Maltheren/Connectivity_3band_LoRaboard/3band_testboard_mcu_based.jpg

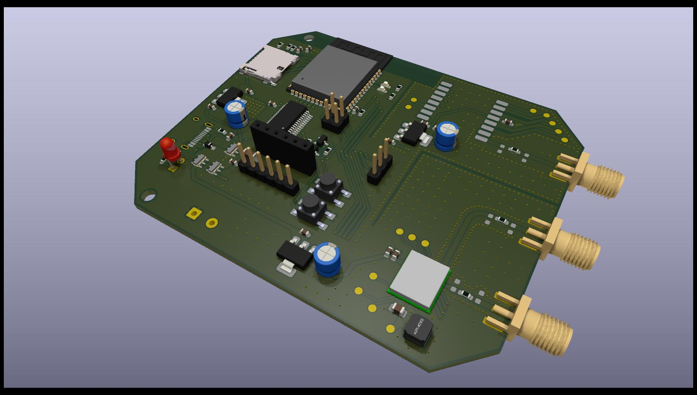
3band_testboard_mcu_based.jpg
