Maltheren/Connectivity_3band_LoRaboard/README.md

# Connectivity_3band_LoRaboard
The first revision lora testboards for the tunnel measurement project
