Maltheren/Connectivity_3band_LoRaboard/Price.ods

Sheet: Sheet1
Component | qty pr board | Price unit | Price tot. | Link
LBAA0XV2GT-001 | 1 | 94.5 | 94.5 | https://eu.mouser.com/ProductDetail/Murata-Electronics/LBAA0XV2GT-001?qs=2wMNvWM5ZX62gobY4BYcIQ%3D%3D
RFM96W-433S2 | 1 | 54.82 | 54.82 | https://www.tme.eu/it/en/details/rfm96w-433s2/rf-modules/hope-microelectronics/
LM1117MPX-3.3 | 3 | 7.03 | 21.09 | https://eu.mouser.com/ProductDetail/Texas-Instruments/LM1117MPX-3.3-NOPB?qs=X1J7HmVL2ZHRbBIxXi4utg%3D%3D
ESP32-S3-WROOM-1-N8R8 | 1 | 25.7 | 25.7 | https://www.mouser.dk/ProductDetail/Espressif-Systems/ESP32-S3-WROOM-1-N8R8?qs=7D1LtPJG0i3%2F28hKFavOpQ%3D%3D
USB-C | 1 | 6.13 | 6.13 | https://dk.farnell.com/gct-global-connector-technology/usb4105-gf-a/usb-conn-2-0-type-c-rcpt-16pos/dp/3588205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
SMA-connectors | 3 | 17.03 | 51.09 | https://www.mouser.dk/ProductDetail/RF-Solutions/CON-SMA-EDGE?qs=UkDUCjYnTB3wOPRCaplkvw%3D%3D&gQT=2
USB-UART | 1 | 34.06 | 34.06 | https://www.mouser.dk/ProductDetail/FTDI/FT232RNL-REEL?qs=By6Nw2ByBD3LSfXryh9qRQ%3D%3D
SD-card socket | 1 | 11.58 | 11.58 | https://www.mouser.dk/ProductDetail/Amphenol-Commercial-Products/1140084168?qs=tcdQdce0DUrgPsHyuD5Law%3D%3D
Switches | 2 | 1.21 | 2.42 | https://www.mouser.co.uk/ProductDetail/E-Switch/TL3305BF100QG?qs=IKkN%2F947nfDIPwqPQja%252BvQ%3D%3D
Inductors | 1 | 1.78 | 1.78 | https://www.mouser.dk/ProductDetail/ABRACON/ASPI-4030S-100M-T?qs=BLmuIjeT3qH3cD5M%252B06ufg%3D%3D
Komponenter pr board: |  |  | 303.17 | dkk
PCB prisoverslag | qty | pris pr pcb | pris total
5 PCB’er med ENIG | 5 | 25.548 | 127.74 | https://cart.jlcpcb.com/quote?orderType=1&stencilLayer=2&stencilWidth=100&stencilLength=100&stencilCounts=5
10 PCB’er med ENIG | 10 | 15.508 | 155.08
Endelig pris pr board: | qty | stk | tot ca. Dkk | Her kommer der lige fragt oveni
 | 5 | 328.718 | 1643.59
 | 10 | 318.678 | 3186.78
Alternativ hvor køber 5 PCB’er. Men kun monterer et par stykker | 2 | 367.04 | 734.08
 | 3 | 345.75 | 1037.25
 | 4 | 335.105 | 1340.42
 | 5 | 328.718 | 1643.59

Sheet: Ark1
Indkøbsliste:
Component | Antal | Pris enhed | Pris tot | Note | Link mouser:
LBAA0XV2GT-001 | 3 | 94.5 | 283.5 | 1 Ekstra | https://eu.mouser.com/ProductDetail/Murata-Electronics/LBAA0XV2GT-001?qs=2wMNvWM5ZX62gobY4BYcIQ%3D%3D
RFM96W-433S2 | 3 | 54.82 | 164.46 | 1 Ekstra | https://www.tme.eu/it/en/details/rfm96w-433s2/rf-modules/hope-microelectronics/
LM1117MPX-3.3 | 10 | 5.06 | 50.6 | 10 koster 8 kr mere, og de kan bruges fremover | https://eu.mouser.com/ProductDetail/Texas-Instruments/LM1117MPX-3.3-NOPB?qs=X1J7HmVL2ZHRbBIxXi4utg%3D%3D
ESP32-S3-WROOM-1-N8R8 | 3 | 25.7 | 77.1 | 1 Ekstra | https://www.mouser.dk/ProductDetail/Espressif-Systems/ESP32-S3-WROOM-1-N8R8?qs=7D1LtPJG0i3%2F28hKFavOpQ%3D%3D
USB-C | 3 | 6.13 | 18.39 | 1 Ekstra | https://dk.farnell.com/gct-global-connector-technology/usb4105-gf-a/usb-conn-2-0-type-c-rcpt-16pos/dp/3588205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
SMA-connectors | 10 | 14.79 | 147.9 | Ekstra vi kommer sandsynligvis til at skulle bruge flere af dem her i frem tiden | https://www.mouser.dk/ProductDetail/RF-Solutions/CON-SMA-EDGE?qs=UkDUCjYnTB3wOPRCaplkvw%3D%3D&gQT=2
USB-UART | 2 | 34.06 | 68.12 |  | https://www.mouser.dk/ProductDetail/FTDI/FT232RNL-REEL?qs=By6Nw2ByBD3LSfXryh9qRQ%3D%3D
SD-card socket | 3 | 11.58 | 34.74 | 1 Ekstra | https://www.mouser.dk/ProductDetail/Amphenol-Commercial-Products/1140084168?qs=tcdQdce0DUrgPsHyuD5Law%3D%3D
Switches | 4 | 1.21 | 4.84 |  | https://www.mouser.dk/ProductDetail/E-Switch/TL3305BF100QG?qs=IKkN%2F947nfDIPwqPQja%252BvQ%3D%3D
Inductors | 3 | 1.78 | 5.34 | 1 Ekstra | https://www.mouser.dk/ProductDetail/ABRACON/ASPI-4030S-100M-T?qs=BLmuIjeT3qH3cD5M%252B06ufg%3D%3D
 |  |  | Total for komonenter:
 |  |  | 854.99 | dkk
PCB | For 5 PCB'er | Fragt | link
Hos JLC. Den billigeste blyfri | 22,34 | 135,46 | https://cart.jlcpcb.com/quote?orderType=1&stencilLayer=2&stencilWidth=100&stencilLength=100
Hos JLC. Med ENIG
