Maltheren/Connectivity_3band_LoRaboard/3band_testboard_mcu_based/Inductor/ASPI-4030S-100M-T.stp

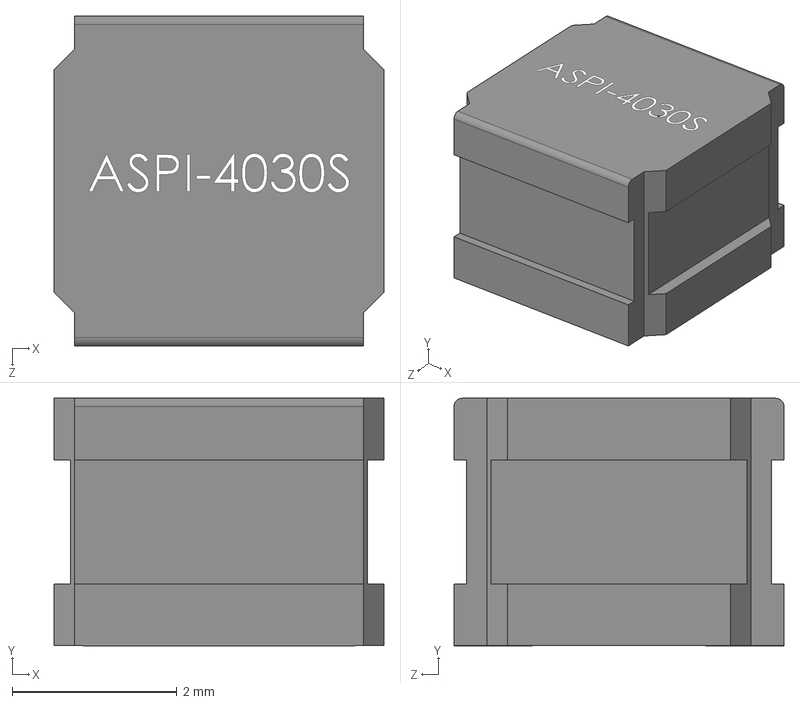
[picture p2: CAD file, 2025-04-08]
3band_testboard_mcu_based/Inductor/ASPI-4030S-100M-T.stp
4.00 x 3.00 x 4.00 mm
