Maltheren/Connectivity_3band_LoRaboard/3band_testboard_mcu_based/LBAA0XV2GT-001/LBAA0XV2GT-001.stp

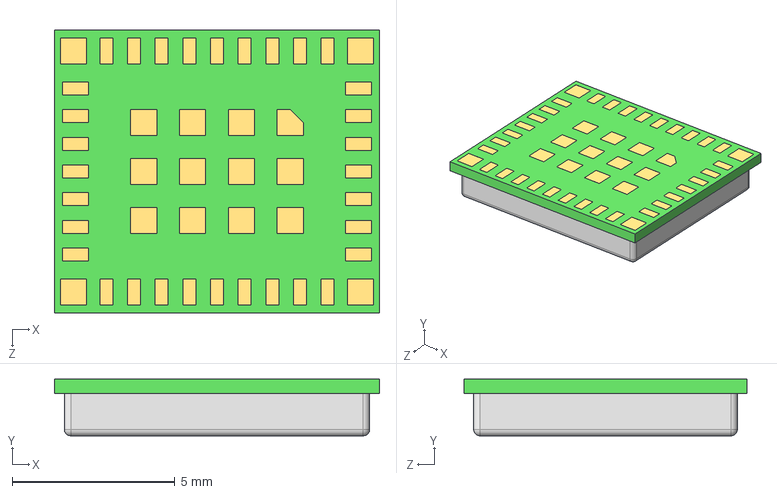
[picture p3: CAD file, 2025-03-31]
3band_testboard_mcu_based/LBAA0XV2GT-001/LBAA0XV2GT-001.stp
9.98 x 1.74 x 8.70 mm
