Maltheren/Connectivity_3band_LoRaboard/3band_testboard_mcu_based/Tactile_switch/TL3305BF100QG.stp

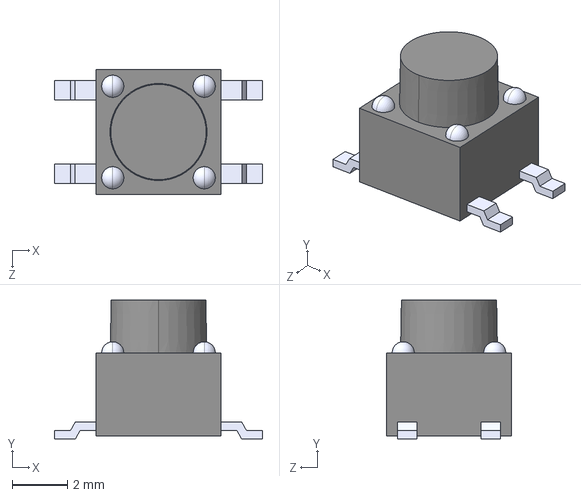
[picture p4: CAD file, 2025-04-08]
3band_testboard_mcu_based/Tactile_switch/TL3305BF100QG.stp
7.50 x 5.00 x 4.50 mm
