Maltheren/Connectivity_3band_LoRaboard/3band_testboard_mcu_based/SD_Card_holder/1140084168.stp

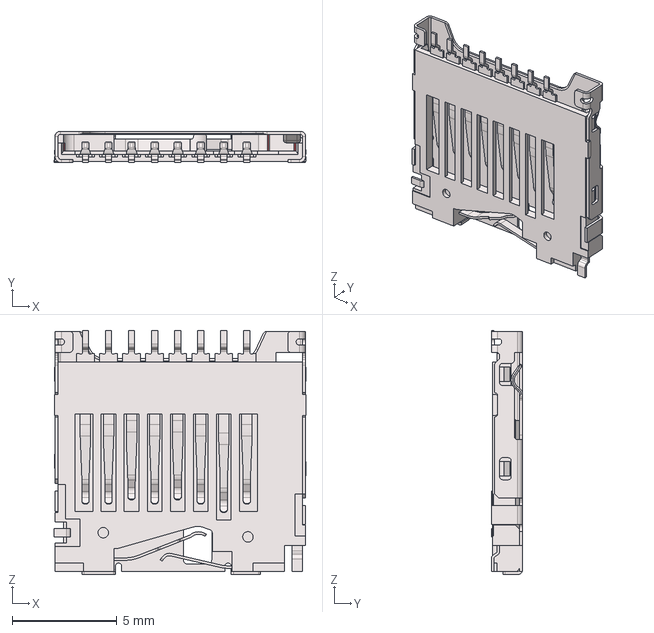
[picture p5: CAD file, 2025-03-31]
3band_testboard_mcu_based/SD_Card_holder/1140084168.stp
12.0 x 1.50 x 11.7 mm
