Maltheren/Connectivity_3band_LoRaboard/Final_Tunnel_SW_HW/Laptop_interface_and_measurements/readme.md

# Measurements and interface for python

### Eval.py
Den henter nogle af de graver frem der kunne bruges

### IOnode.py
Var den orignale kode der blev kørt for at hente værdierne sammen med rullebordet i tunnellen

### Rulletest1 mappen
Målinger udført med  
BW=500kHz, SF=6, CR=7
