Maltheren/Connectivity_3band_LoRaboard/3band_testboard_mcu_based/3band_testboard_mcu_based.kicad_pcb

## KiCad design 3band_testboard_mcu_based/3band_testboard_mcu_based.kicad_pcb (2025-05-11)

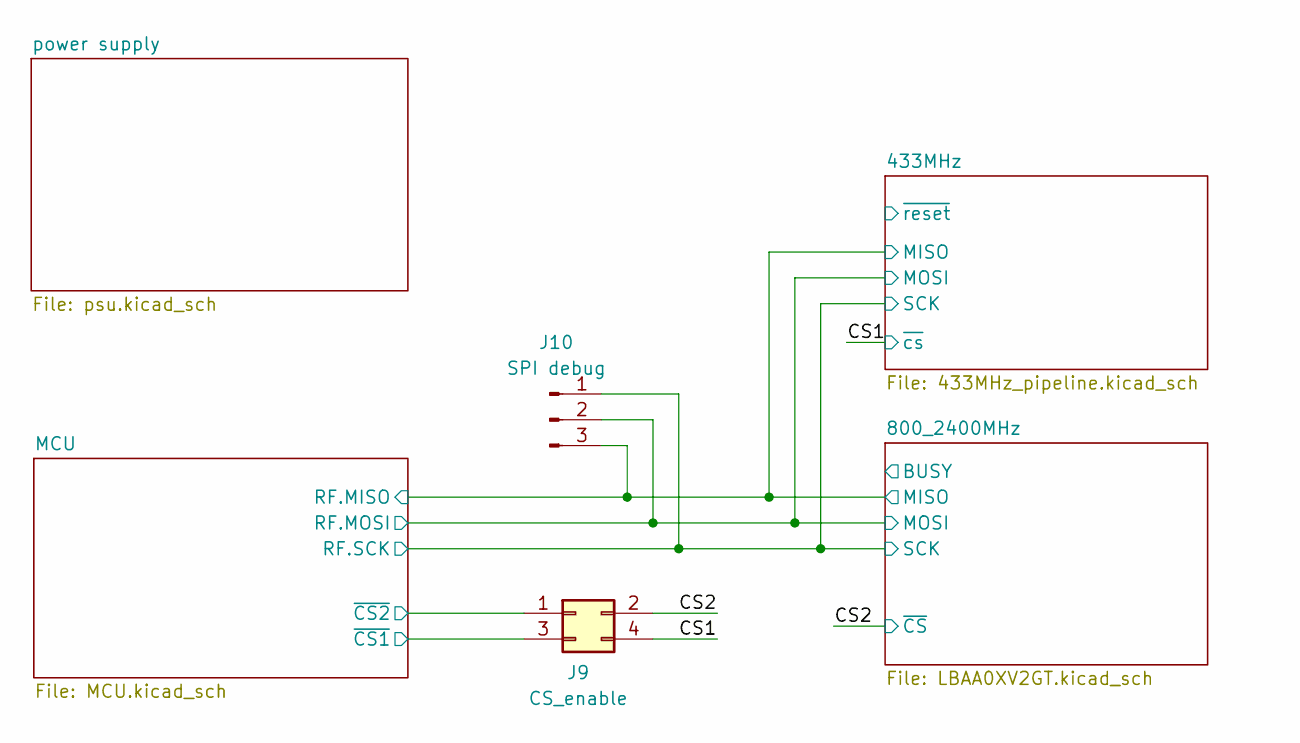
[picture p6: schematic 3band_testboard_mcu_based.kicad_sch, 3-band-LoRa testboard]

Parts:
J9: CS_enable; PinHeader_2x02_P2.54mm_Vertical
J10: SPI debug; PinHeader_1x03_P2.54mm_Vertical

Connections:
/433MHz/MISO: J10.3; also elsewhere on the board
/433MHz/MOSI: J10.2; also elsewhere on the board
/433MHz/SCK: J10.1; also elsewhere on the board
/CS1: J9.4; also elsewhere on the board
/CS2: J9.2; also elsewhere on the board
/MCU/~CS1: J9.3; also elsewhere on the board
/MCU/~CS2: J9.1; also elsewhere on the board

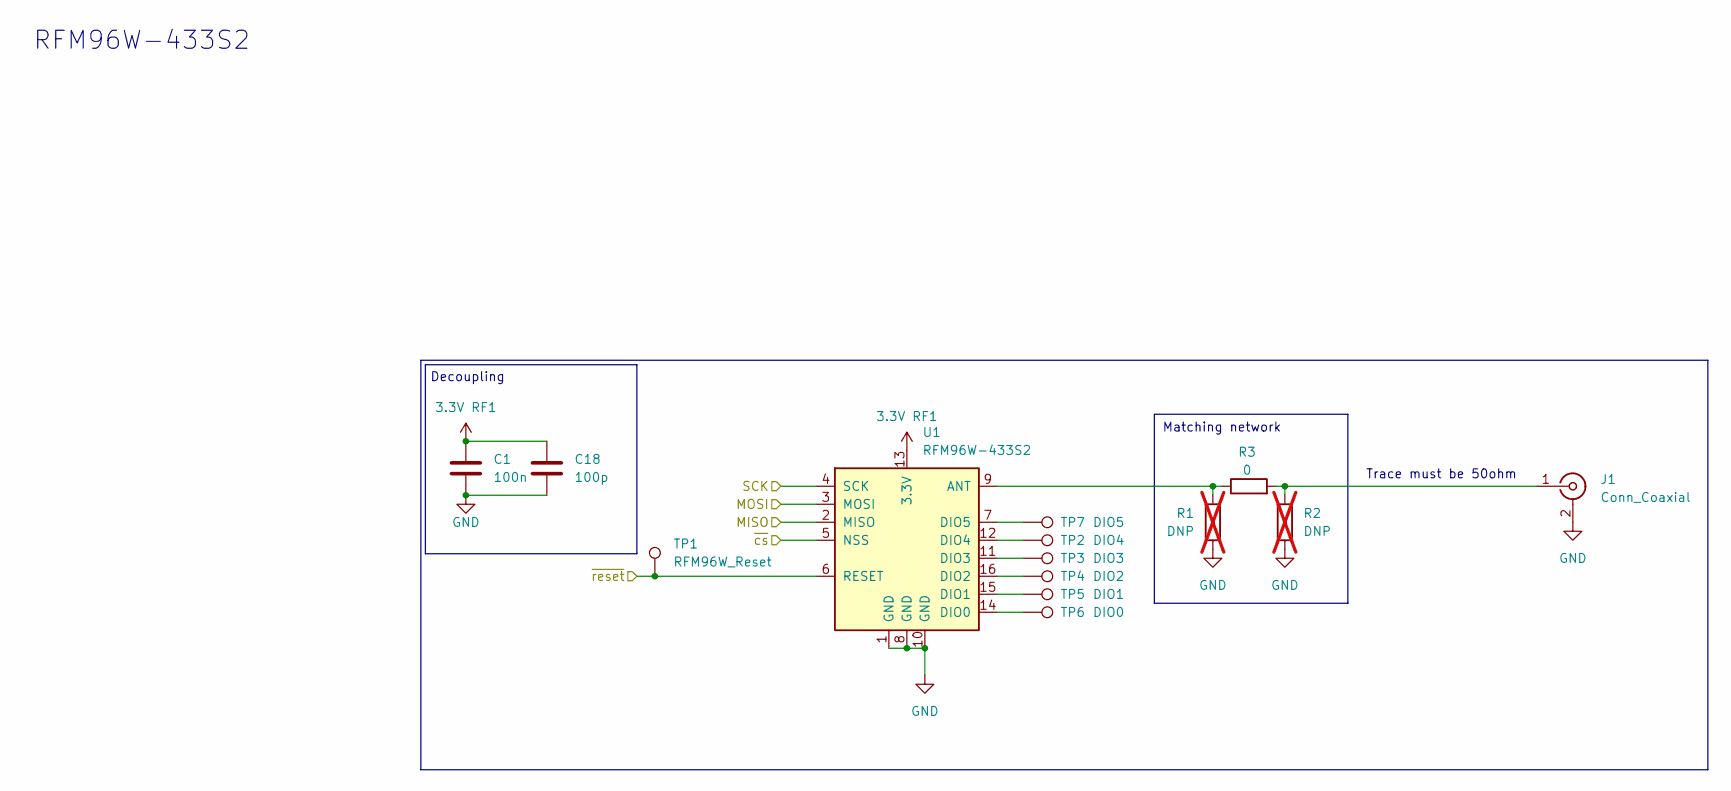
[picture p7: schematic 433MHz_pipeline.kicad_sch, 3-band-LoRa testboard]

Parts:
C1: 100n; C_0603_1608Metric_Pad1.08x0.95mm_HandSolder
C18: 100p; C_0603_1608Metric_Pad1.08x0.95mm_HandSolder
J1: Conn_Coaxial; SMA_Samtec_SMA-J-P-H-ST-EM1_EdgeMount
R1, R2: DNP; R_0603_1608Metric_Pad0.98x0.95mm_HandSolder; not fitted
R3: 0; R_0603_1608Metric_Pad0.98x0.95mm_HandSolder
TP1: RFM96W_Reset; TestPoint_Pad_D1.5mm
TP2: DIO4; TestPoint_Pad_D1.5mm
TP3: DIO3; TestPoint_Pad_D1.5mm
TP4: DIO2; TestPoint_Pad_D1.5mm
TP5: DIO1; TestPoint_Pad_D1.5mm
TP6: DIO0; TestPoint_Pad_D1.5mm
TP7: DIO5; TestPoint_Pad_D1.5mm
U1: RFM96W-433S2; HOPERF_RFM9XW_SMD

Connections:
3.3V RF1: C1.1, C18.1, U1.13 (3.3V); also elsewhere on the board
/433MHz/MISO: U1.2 (MISO); also elsewhere on the board
/433MHz/MOSI: U1.3 (MOSI); also elsewhere on the board
/433MHz/SCK: U1.4 (SCK); also elsewhere on the board
/433MHz/~reset: TP1.1, U1.6 (RESET)
/CS1: U1.5 (NSS); also elsewhere on the board
GND: C1.2, C18.2, J1.2 (Ext), R1.2, R2.2, U1.1 (GND), U1.8 (GND), U1.10 (GND); also elsewhere on the board
unnamed: J1.1 (In), R2.1, R3.2
unnamed: R1.1, R3.1, U1.9 (ANT)
unnamed: TP6.1, U1.14 (DIO0)
unnamed: TP5.1, U1.15 (DIO1)
unnamed: TP4.1, U1.16 (DIO2)
unnamed: TP3.1, U1.11 (DIO3)
unnamed: TP2.1, U1.12 (DIO4)
unnamed: TP7.1, U1.7 (DIO5)

Notes on the sheet:
RFM96W-433S2
Matching network
Trace must be 50ohm
Decoupling

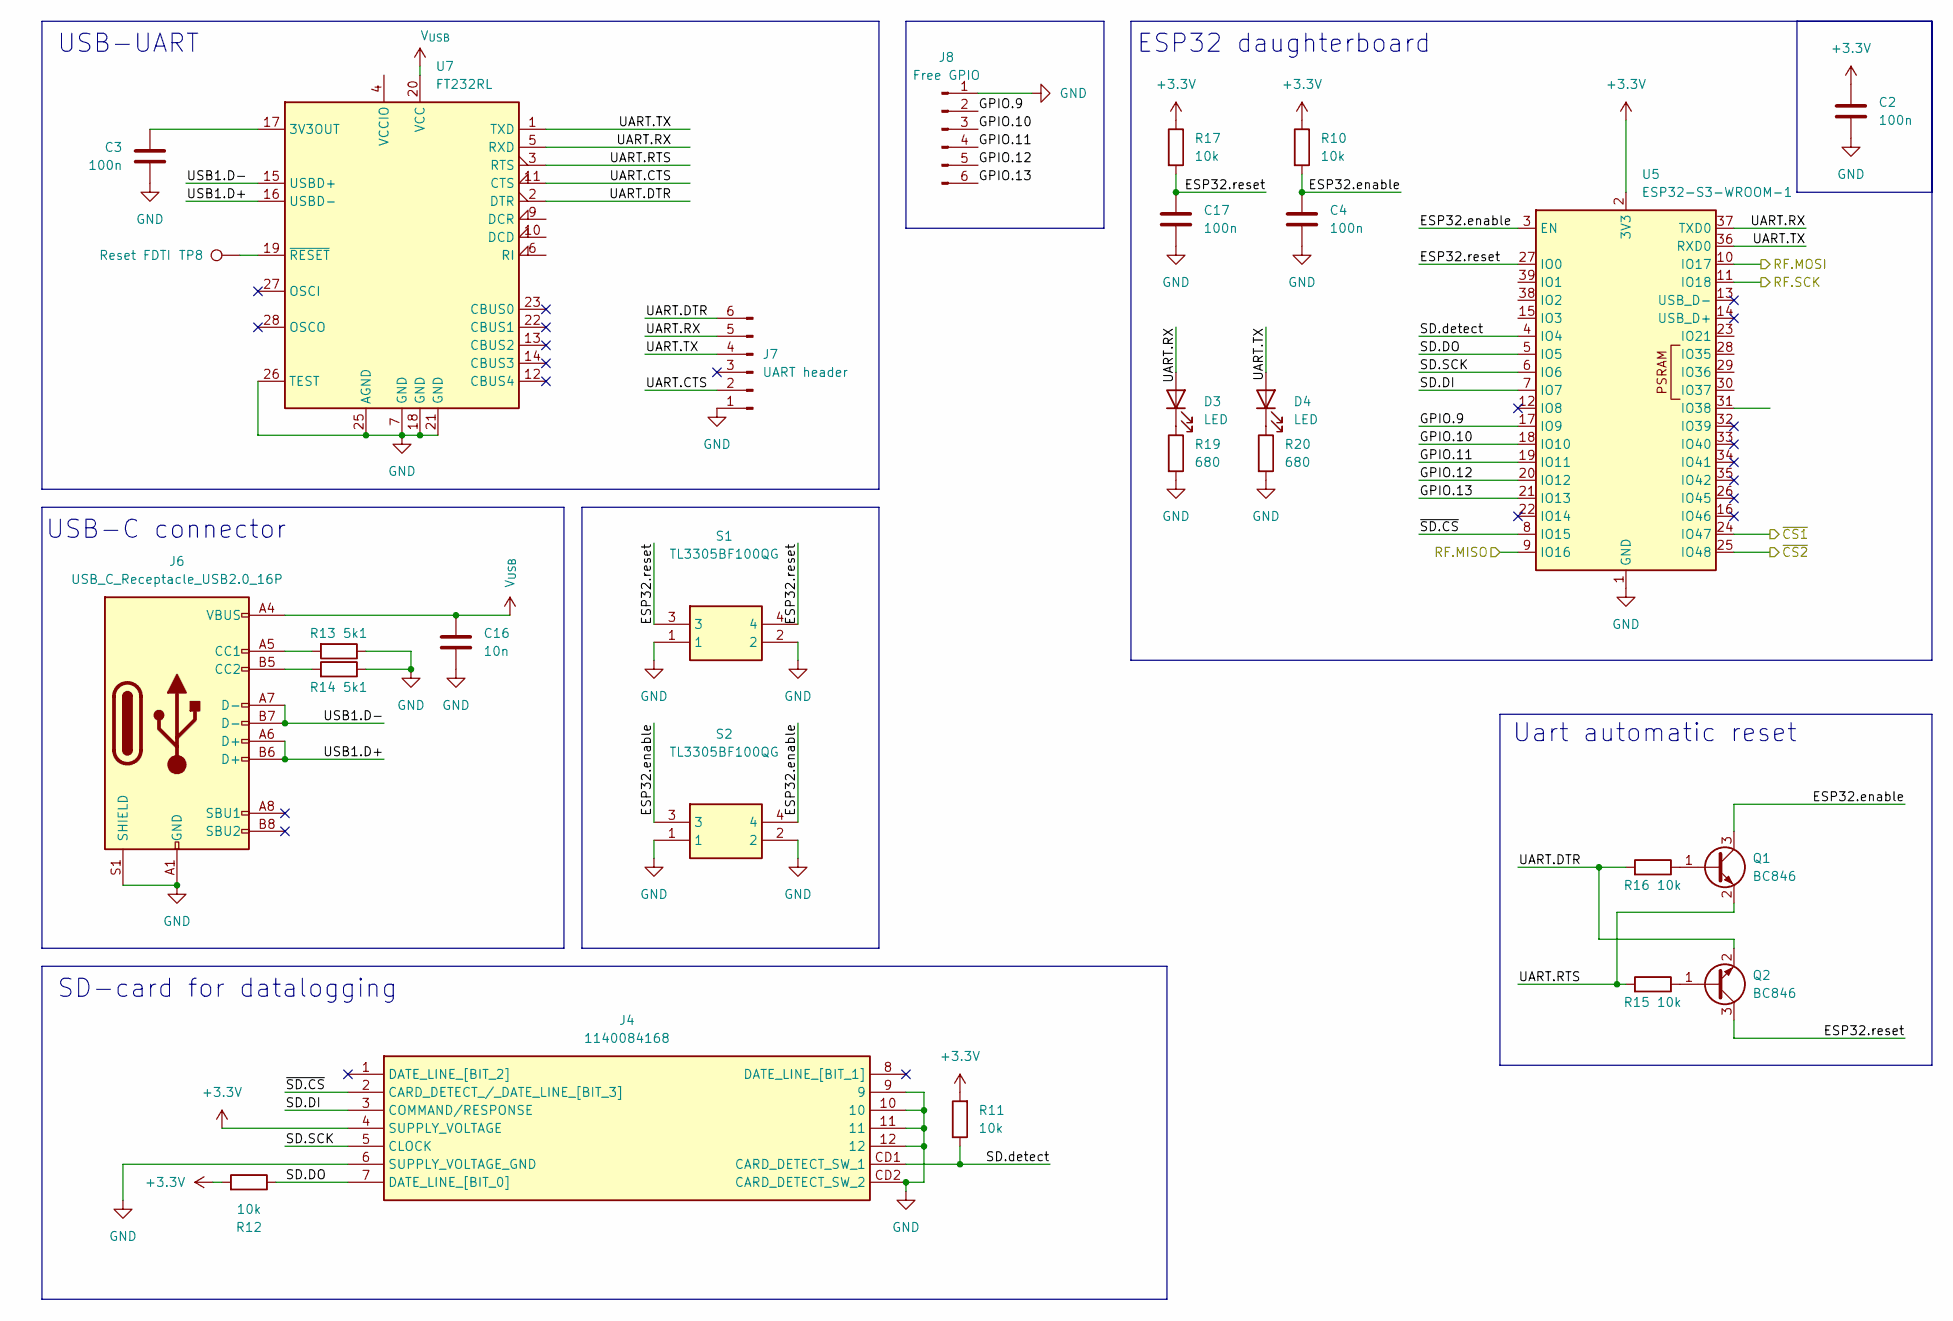
[picture p8: schematic MCU.kicad_sch, 3-band-LoRa testboard]

Parts:
C2, C3, C4, C17: 100n; C_0603_1608Metric
C16: 10n; C_0603_1608Metric
D3, D4: LED; LED_0603_1608Metric_Pad1.05x0.95mm_HandSolder
J4: 1140084168; Manufacturer_Part_Number 1140084168; Mouser Part Number 523-114-00841-68
J6: USB_C_Receptacle_USB2.0_16P; USB_C_Receptacle_HRO_TYPE-C-31-M-12
J7: UART header; PinSocket_1x06_P2.54mm_Vertical
J8: Free GPIO; PinHeader_1x06_P2.54mm_Vertical
Q1, Q2: BC846; SOT-23
R10, R11, R12, R15, R16, R17: 10k; R_0603_1608Metric
R13, R14: 5k1; R_0603_1608Metric
R19, R20: 680; R_0603_1608Metric
S1, S2: TL3305BF100QG; TL3305BF160QG; Mouser Part Number 612-TL3305BF100QG
TP8: Reset FDTI; TestPoint_Pad_D1.5mm
U5: ESP32-S3-WROOM-1
U7: FT232RL; SSOP-28_5.3x10.2mm_P0.65mm

Connections:
+3.3V: C2.1, J4.4 (SUPPLY_VOLTAGE), R10.1, R11.2, R12.2, R17.1, U5.2 (3V3); also elsewhere on the board
/433MHz/MISO: U5.9 (IO16); also elsewhere on the board
/433MHz/MOSI: U5.10 (IO17); also elsewhere on the board
/433MHz/SCK: U5.11 (IO18); also elsewhere on the board
/MCU/ESP32.enable: C4.1, Q1.3 (C), R10.2, S2.3, S2.4, U5.3 (EN)
/MCU/ESP32.reset: C17.1, Q2.3 (C), R17.2, S1.3, S1.4, U5.27 (IO0)
/MCU/GPIO.9: J8.2, U5.17 (IO9)
/MCU/GPIO.10: J8.3, U5.18 (IO10)
/MCU/GPIO.11: J8.4, U5.19 (IO11)
/MCU/GPIO.12: J8.5, U5.20 (IO12)
/MCU/GPIO.13: J8.6, U5.21 (IO13)
/MCU/SD.DI: J4.3 (COMMAND/RESPONSE), U5.7 (IO7)
/MCU/SD.DO: J4.7 (DATE_LINE_[BIT_0]), R12.1, U5.5 (IO5)
/MCU/SD.SCK: J4.5 (CLOCK), U5.6 (IO6)
/MCU/SD.detect: J4.CD1 (CARD_DETECT_SW_1), R11.1, U5.4 (IO4)
/MCU/UART.CTS: J7.2, U7.11 (CTS)
/MCU/UART.DTR: J7.6, Q2.2 (E), R16.2, U7.2 (DTR)
/MCU/UART.RTS: Q1.2 (E), R15.2, U7.3 (RTS)
/MCU/UART.RX: D3.2 (A), J7.5, U5.37 (TXD0), U7.5 (RXD)
/MCU/UART.TX: D4.2 (A), J7.4, U5.36 (RXD0), U7.1 (TXD)
/MCU/USB1.D+: J6.A6 (D+), J6.B6 (D+), U7.16 (USBD-)
/MCU/USB1.D-: J6.A7 (D-), J6.B7 (D-), U7.15 (USBD+)
/MCU/~CS1: U5.24 (IO47); also elsewhere on the board
/MCU/~CS2: U5.25 (IO48); also elsewhere on the board
/MCU/~SD.CS: J4.2 (CARD_DETECT_/_DATE_LINE_[BIT_3]), U5.8 (IO15)
GND: C2.2, C3.2, C4.2, C16.2, C17.2, J4.6 (SUPPLY_VOLTAGE_GND), J4.9, J4.10, J4.11, J4.12, J4.CD2 (CARD_DETECT_SW_2), J6.A1 (GND), J6.A12 (GND), J6.B1 (GND), J6.B12 (GND), J6.S1 (SHIELD), J7.1, J8.1, R13.1, R14.1, R19.2, R20.2, S1.1, S1.2, S2.1, S2.2, U5.1 (GND), U5.40 (GND), U5.41 (GND), U7.7 (GND), U7.18 (GND), U7.21 (GND), U7.25 (AGND), U7.26 (TEST); also elsewhere on the board
unnamed: D3.1 (K), R19.1
unnamed: D4.1 (K), R20.1
unnamed: J6.A5 (CC1), R13.2
unnamed: J6.B5 (CC2), R14.2
unnamed: Q1.1 (B), R16.1
unnamed: Q2.1 (B), R15.1
unnamed: C3.1, U7.17 (3V3OUT)
unnamed: TP8.1, U7.19 (~RESET)
V_{USB}: C16.1, J6.A4 (VBUS), J6.A9 (VBUS), J6.B4 (VBUS), J6.B9 (VBUS), U7.20 (VCC); also elsewhere on the board

Notes on the sheet:
USB-UART
USB-C connector
Uart automatic reset
SD-card for datalogging
ESP32 daughterboard

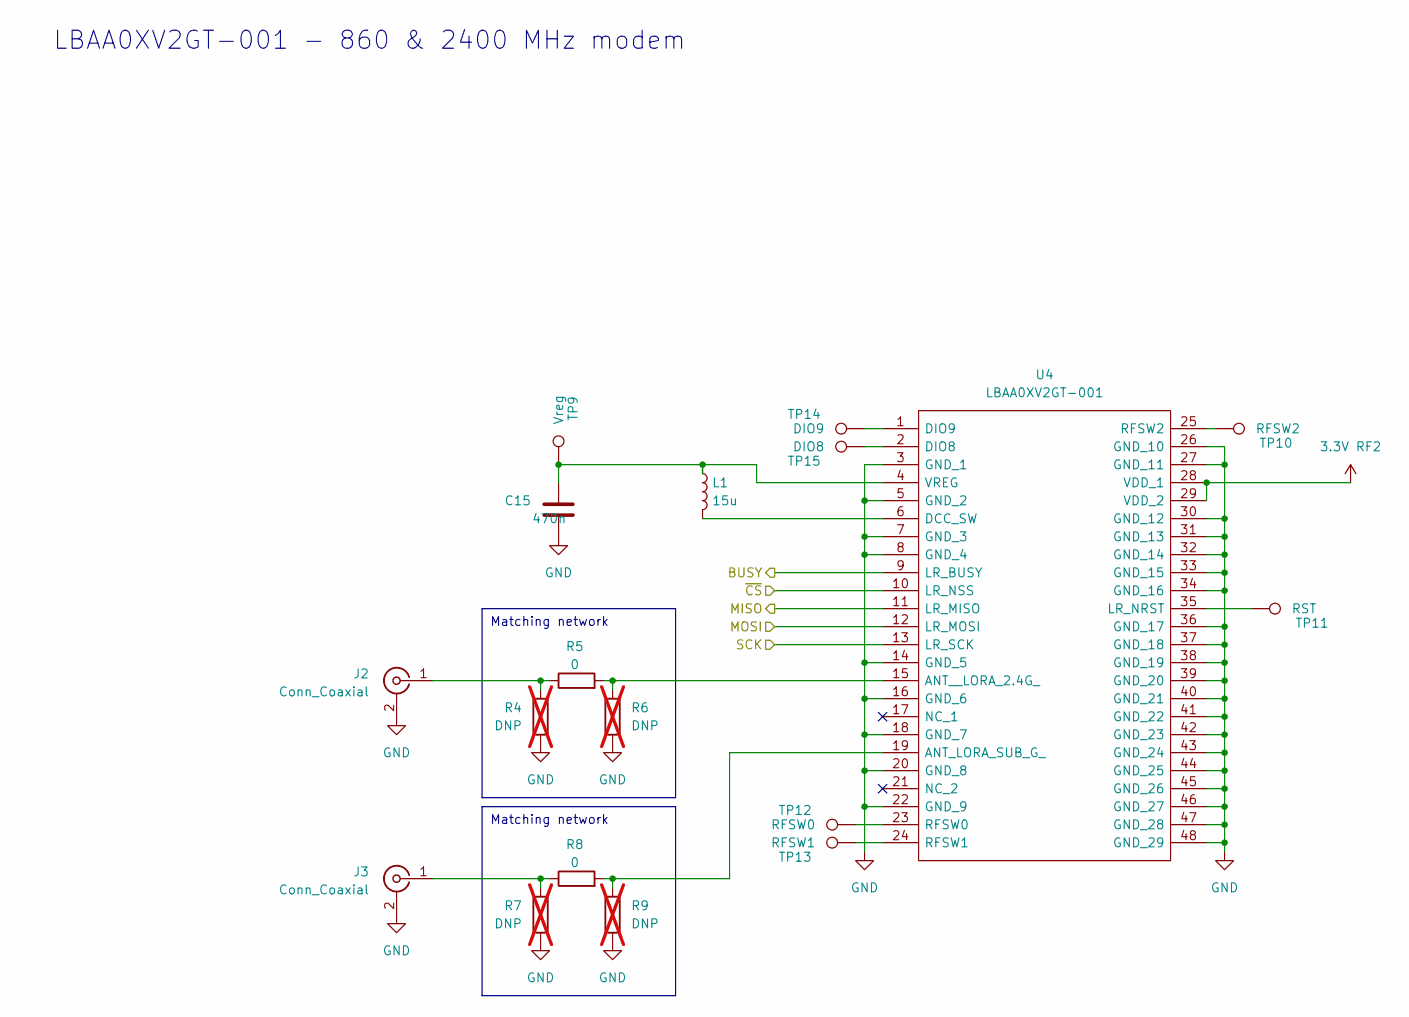
[picture p9: schematic LBAA0XV2GT.kicad_sch, 3-band-LoRa testboard]

Parts:
C15: 470n; C_0805_2012Metric_Pad1.18x1.45mm_HandSolder
J2, J3: Conn_Coaxial; SMA_Samtec_SMA-J-P-H-ST-EM1_EdgeMount
L1: 15u; ASPI-4030S
R4, R6, R7, R9: DNP; R_0603_1608Metric_Pad0.98x0.95mm_HandSolder; not fitted
R5, R8: 0; R_0603_1608Metric_Pad0.98x0.95mm_HandSolder
TP9: Vreg; TestPoint_Pad_D1.5mm
TP10: RFSW2; TestPoint_Pad_D1.5mm
TP11: RST; TestPoint_Pad_D1.5mm
TP12: RFSW0; TestPoint_Pad_D1.5mm
TP13: RFSW1; TestPoint_Pad_D1.5mm
TP14: DIO9; TestPoint_Pad_D1.5mm
TP15: DIO8; TestPoint_Pad_D1.5mm
U4: LBAA0XV2GT-001; LBAA0XV2GT001; Manufacturer_Part_Number LBAA0XV2GT-001

Connections:
3.3V RF2: U4.28 (VDD_1), U4.29 (VDD_2); also elsewhere on the board
/433MHz/MISO: U4.11 (LR_MISO); also elsewhere on the board
/433MHz/MOSI: U4.12 (LR_MOSI); also elsewhere on the board
/433MHz/SCK: U4.13 (LR_SCK); also elsewhere on the board
/800_2400MHz/BUSY: U4.9 (LR_BUSY)
/CS2: U4.10 (LR_NSS); also elsewhere on the board
GND: C15.1, J2.2 (Ext), J3.2 (Ext), R4.2, R6.2, R7.2, R9.2, U4.3 (GND_1), U4.5 (GND_2), U4.7 (GND_3), U4.8 (GND_4), U4.14 (GND_5), U4.16 (GND_6), U4.18 (GND_7), U4.20 (GND_8), U4.22 (GND_9), U4.26 (GND_10), U4.27 (GND_11), U4.30 (GND_12), U4.31 (GND_13), U4.32 (GND_14), U4.33 (GND_15), U4.34 (GND_16), U4.36 (GND_17), U4.37 (GND_18), U4.38 (GND_19), U4.39 (GND_20), U4.40 (GND_21), U4.41 (GND_22), U4.42 (GND_23), U4.43 (GND_24), U4.44 (GND_25), U4.45 (GND_26), U4.46 (GND_27), U4.47 (GND_28), U4.48 (GND_29); also elsewhere on the board
unnamed: J2.1 (In), R4.1, R5.1
unnamed: J3.1 (In), R7.1, R8.1
unnamed: R8.2, R9.1, U4.19 (ANT_LORA_SUB_G_)
unnamed: R5.2, R6.1, U4.15 (ANT__LORA_2.4G_)
unnamed: L1.2, U4.6 (DCC_SW)
unnamed: TP15.1, U4.2 (DIO8)
unnamed: TP14.1, U4.1 (DIO9)
unnamed: TP11.1, U4.35 (LR_NRST)
unnamed: TP12.1, U4.23 (RFSW0)
unnamed: TP13.1, U4.24 (RFSW1)
unnamed: TP10.1, U4.25 (RFSW2)
unnamed: C15.2, L1.1, TP9.1, U4.4 (VREG)

Notes on the sheet:
LBAA0XV2GT-001 - 860 & 2400 MHz modem
Matching network

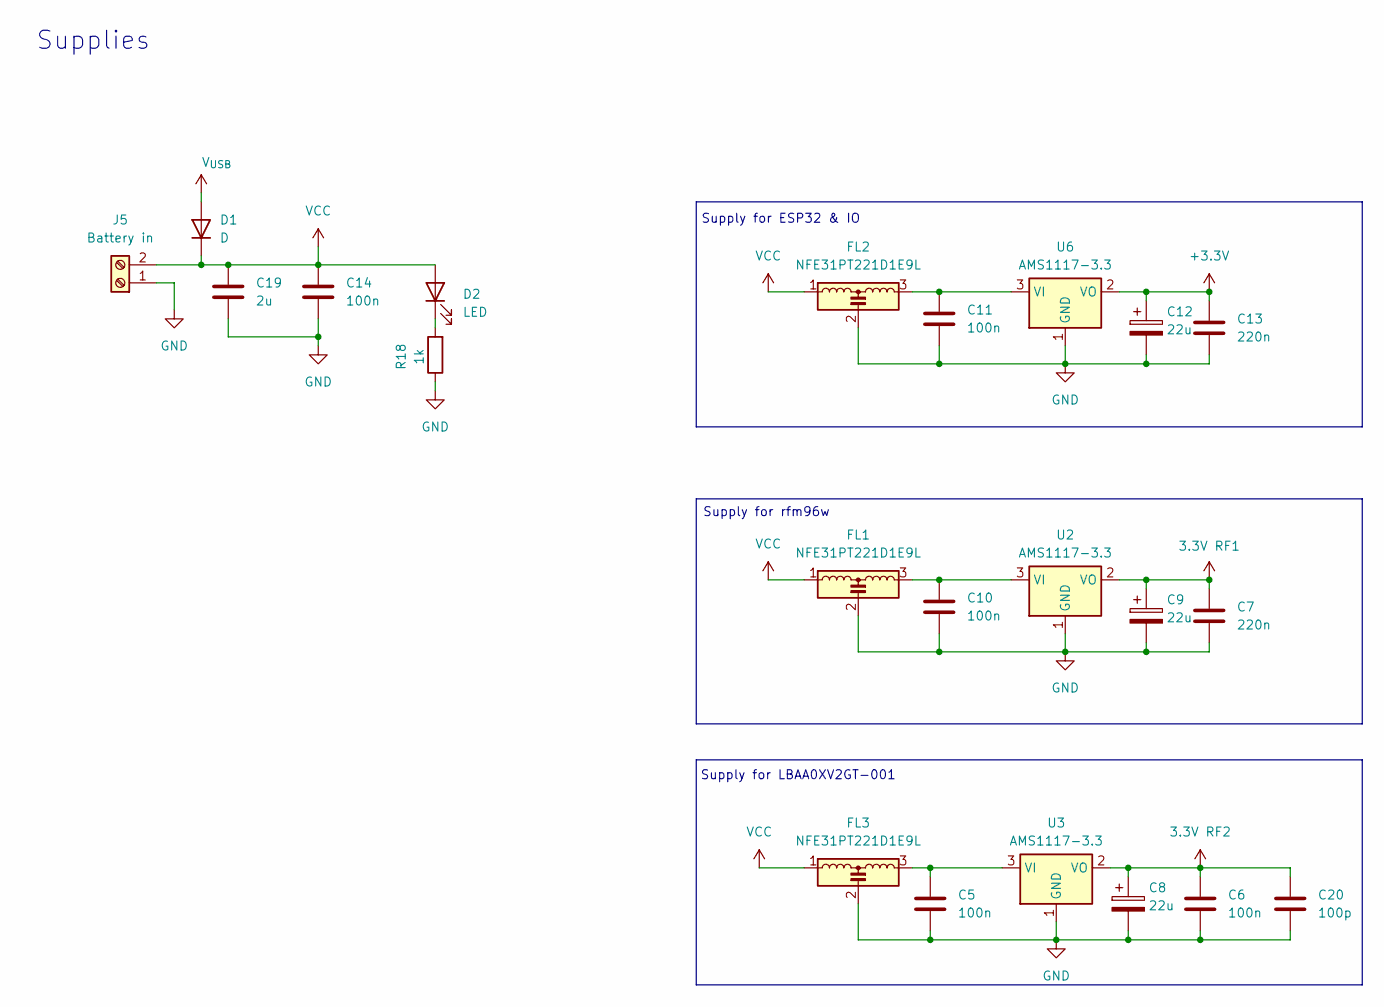
[picture p10: schematic psu.kicad_sch, 3-band-LoRa testboard]

Parts:
C5, C6, C10, C11, C14: 100n; C_0603_1608Metric
C7, C13: 220n; C_0603_1608Metric
C8, C9, C12: 22u; CP_Radial_D5.0mm_P2.50mm
C19: 2u; C_1206_3216Metric_Pad1.33x1.80mm_HandSolder
C20: 100p; C_0603_1608Metric
D1: D; D_SOD-323_HandSoldering
D2: LED; LED_D3.0mm
FL1, FL2, FL3: NFE31PT221D1E9L; Resonator_SMD_Murata_CSTxExxV-3Pin_3.0x1.1mm_HandSoldering
J5: Battery in; TerminalBlock_RND_205-00012_1x02_P5.00mm_Horizontal
R18: 1k; R_0603_1608Metric_Pad0.98x0.95mm_HandSolder
U2, U3, U6: AMS1117-3.3; SOT-223-3_TabPin2

Connections:
3.3V RF1: C7.1, C9.1, U2.2 (VO); also elsewhere on the board
3.3V RF2: C6.1, C8.1, C20.1, U3.2 (VO); also elsewhere on the board
+3.3V: C12.1, C13.1, U6.2 (VO); also elsewhere on the board
GND: C5.2, C6.2, C7.2, C8.2, C9.2, C10.2, C11.2, C12.2, C13.2, C14.2, C19.2, C20.2, FL1.2, FL2.2, FL3.2, J5.1, R18.1, U2.1 (GND), U3.1 (GND), U6.1 (GND); also elsewhere on the board
unnamed: D2.1 (K), R18.2
unnamed: C10.1, FL1.3, U2.3 (VI)
unnamed: C5.1, FL3.3, U3.3 (VI)
unnamed: C11.1, FL2.3, U6.3 (VI)
VCC: C14.1, C19.1, D1.1 (K), D2.2 (A), FL1.1, FL2.1, FL3.1, J5.2
V_{USB}: D1.2 (A); also elsewhere on the board

Notes on the sheet:
Supplies
Supply for ESP32 & IO
Supply for rfm96w
Supply for LBAA0XV2GT-001

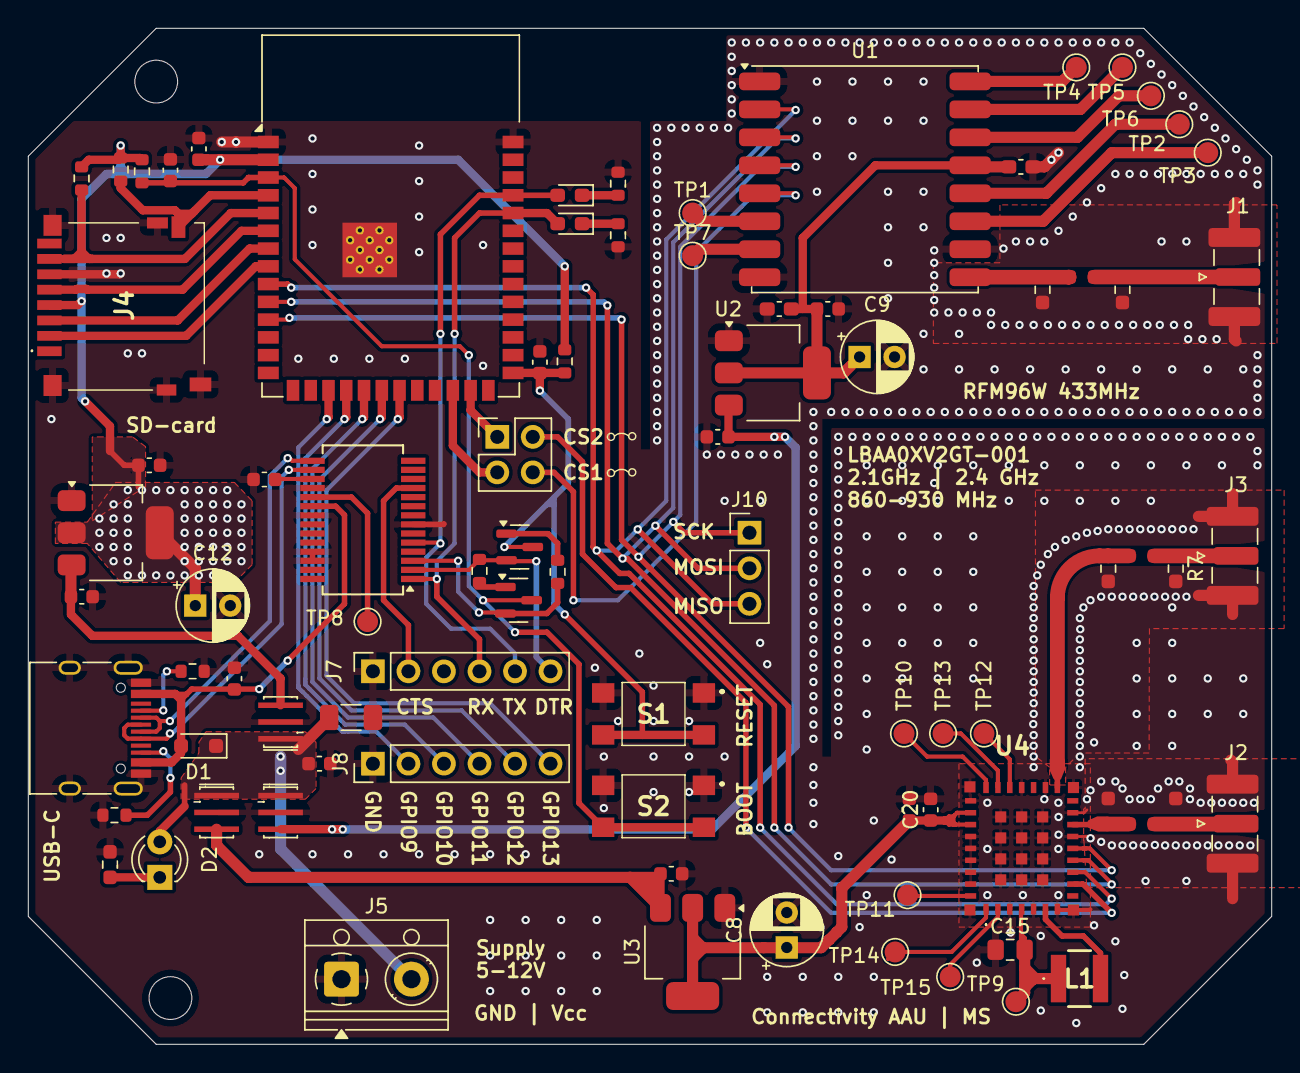
[picture p11: board 3band_testboard_mcu_based.kicad_pcb from above]

Board: 2 copper layers, 88.9 x 72.6 mm, 84 parts (0 on the bottom side), 65 nets.
