Maltheren/Connectivity_3band_LoRaboard/(commit log)

2025-03-31 Inital commit
    [1140084168.stp, 3band_testboard_mcu_based.kicad_pcb, 3band_testboard_mcu_based.kicad_sch, 433MHz_pipeline.kicad_sch, LBAA0XV2GT-001.stp, LBAA0XV2GT.kicad_sch, MCU.kicad_sch, psu.kicad_sch]
2025-04-04 Færdiggjorde GPIO
    [3band_testboard_mcu_based.kicad_pcb, 3band_testboard_mcu_based.kicad_sch, 433MHz_pipeline.kicad_sch, LBAA0XV2GT.kicad_sch, MCU.kicad_sch, psu.kicad_sch]
2025-04-08 DRC check, and price
    [3band_testboard_mcu_based.kicad_pcb, 3band_testboard_mcu_based.kicad_sch, 433MHz_pipeline.kicad_sch, ASPI-4030S-100M-T.stp, LBAA0XV2GT.kicad_sch, MCU.kicad_sch, Price.ods, TL3305BF100QG.stp]
2025-04-29 Drivers and code
2025-05-11 nothing works
    [3band_testboard_mcu_based.kicad_pcb]
2025-09-18 various measurements
    [pyvenv.cfg]
